rosco-m68k/rosco_m68k_pro/code/firmware/rosco_m68k_pro_development/README.md

# rosco_m68k Pro Firmware (development)

Developmental firmware for rosco_m68k pro. Currently WIP.
