rosco-m68k/rosco_m68k_pro/(threads)

Thread 9 (2021-12-07):

LED Blink on Pro is unreliable

roscopeco, 2021-12-07:
Duplicates https://github.com/rosco-m68k/rosco_m68k/issues/282 (issue is in code brought over from classic r2).

Will push a PR to fix shortly.

Closed 2021-12-08.
