rosco-m68k/rosco_m68k_pro/(list of files, drawings)

Other design files:
code/pld/mem_selects/selects.circ
