rosco-m68k/rosco_m68k_pro/(commit log)

2021-05-15 Initial work on design
    [CPU.sch, DUART.sch, GLUE.sch, RAM.sch, ROM.sch, rosco_pro_mini_040.kicad_pcb, rosco_pro_mini_040.sch]
2021-05-21 Initial import 030 design dev
    [CPU.sch, DUART.sch, GLUE.sch, RAM.sch, ROM.sch, rosco_pro_mini_030.kicad_pcb, rosco_pro_mini_030.sch]
2021-07-16 Update footprints for pro 030 mini
    [CPU.sch]
2021-07-16 Remove abortive minis, moving to full prototype
    [CPU.sch, DUART.sch, GLUE.sch, RAM.sch, ROM.sch, rosco_pro_mini_030.kicad_pcb, rosco_pro_mini_030.sch, rosco_pro_mini_040.kicad_pcb]
2021-07-16 First cut IC2 (L1 address decoder)
2021-07-16 First cut L2 decoder (O/B mem selects)
    [selects.circ]
2021-07-16 Initial work on 030 proto
    [CPU.sch, DUART.sch, GALs.sch, GLUE.sch, RAM.sch, ROM.sch, rosco_pro_030_proto.kicad_pcb, rosco_pro_030_proto.sch]
2021-07-23 First cut interrupt glue GAL
2021-07-23 Add interrupt glue to schematic
    [CPU.sch, DUART.sch, GALs.sch, GLUE.sch, RAM.sch, RESET.sch, ROM.sch, rosco_pro_030_proto.sch]
2021-07-24 Largeish changeset:
    * Added (first-cut) glue for DTACK generation
    * Fix mem selects to use new DTACK generation
    * Add missing footprints for Kicad
    * Add POWER and TESTPOINTS schematics
    * Update footprints across the board to allow error-free PCB import
    * Pull all components (so far) into PCB
    * Fix MC68030RC footprint (missing pads)
    [CPU.sch, DUART.sch, GALs.sch, GLUE.sch, POWER.sch, RAM.sch, RESET.sch, ROM.sch]
2021-07-25 Add DTACK delays and fixes
    * Add configurable DTACK delay for RAM & ROM
    * Add DTACK generation for RAM/ROM with delay support in IC5
    * Fix /BOOT line generator for 32-bit port
    [GALs.sch, GLUE.sch]
2021-07-25 Make DTACK delay input selectable, and update netlist
    [GLUE.sch, rosco_pro_030_proto.kicad_pcb]
2021-08-23 Interrupts + Xosera schematic, re-annotate
    [CPU.sch, DUART.sch, GALs.sch, GLUE.sch, INTERRUPTS.sch, LEVELSHIFT.sch, POWER.sch, RAM.sch]
2021-09-20 Big(ish) push on placement
    [CPU.sch, DUART.sch, GLUE.sch, INTERRUPTS.sch, POWER.sch, RESET.sch, rosco_pro_030_proto.kicad_pcb]
2021-09-23 Further layout
    [CPU.sch, GALs.sch, GLUE.sch, INTERRUPTS.sch, LEVELSHIFT.sch, POWER.sch, RESET.sch, XOSERA.sch]
2021-10-01 Add IO and XVID glue etc.
    * Add IO Select glue
    * Add Xosera glue
    * Add new glues to schematic
    * Clean up libs
    * Reannotate (again)
    [DUART.sch, GALs.sch, GLUE.sch, INTERRUPTS.sch, LEVELSHIFT.sch, POWER.sch, RESET.sch, XOSERA.sch]
2021-10-01 Use IACK signals from interrupt glue
2021-10-01 Finally fix ERC...
    [CPU.sch, GALs.sch, INTERRUPTS.sch, POWER.sch, RAM.sch, TESTPOINTS.sch, rosco_pro_030_proto.kicad_pcb]
2021-10-01 Lots of work
    * Sort out power and reset circuits, add ATX
    * Add PCF8584 and supporting GAL code
    * Stub out ATX board outline in PCB
    * Various other tidying up and prep for layout
    [CPU.sch, DUART.sch, GALs.sch, GLUE.sch, INTERFACE.sch, INTERRUPTS.sch, LEVELSHIFT.sch, POWER.sch]
2021-10-01 Reconnect PCF8584 clock to CLK_8M
    [INTERFACE.sch, rosco_pro_030_proto.kicad_pcb]
2021-10-01 3V3 decoupling / filtering
    [POWER.sch, rosco_pro_030_proto.kicad_pcb]
2021-10-01 First cut placement
    [GALs.sch, LEVELSHIFT.sch, POWER.sch, XOSERA.sch]
2021-10-07 Replace 7493s and 7404 with IC10 GAL
    [GALs.sch, GLUE.sch, POWER.sch, UNUSED.sch, XOSERA.sch]
2021-10-07 Replace all 7400 reset glue / boot logic with PLD
2021-10-07 Add IC14 GAL into schematic
    [GALs.sch, GLUE.sch, RESET.sch, UNUSED.sch]
2021-10-07 BOOT line requires 2 clocks, not 4, on 030
    [GALs.sch]
2021-10-31 Use correct ATX footprint and fix boot line routing
    [POWER.sch, rosco_pro_030_proto.csv]
2021-11-03 Fix some silly mistakes
    [CPU.sch, GLUE.sch, POWER.sch, RESET.sch]
2021-11-03 Unused wire removal
    [ROM.sch]
2021-11-20 Lots more changes
    * Add DIN expansion connectors (provisional pinout)
    * Fix incorrect address lines for RAM & ROM (Doh!)
    * Remove unused level shifters
    * Fix clock enables
    * Lots of other small fixes
    [CPU.sch, DUART.sch, GALs.sch, GLUE.sch, INTERFACE.sch, INTERRUPTS.sch, POWER.sch, RAM.sch]
2021-11-20 Add DIN41612 footprint
2021-11-30 Fix RW/RnW SNAFU
    [GALs.sch, INTERFACE.sch, XOSERA.sch]
2021-11-30 Fix DUART DTACK SNAFU
    [DUART.sch]
2021-11-30 Completely re-do selects with negative logic
    [selects.circ]
2021-11-30 Fix (another) hilarious mistake 😞
    * 8-bit ports wired to the wrong end of the bus
    * Another respin needed I think...
    [DUART.sch, INTERFACE.sch, XOSERA.sch]
2021-12-01 Individual device selects are active low too
2021-12-01 Fix new RRSEL in schematic
    [GALs.sch]
2021-12-02 Global replace 'firmware v2' with 'Pro Firmware'
    [ansicon.asm, ata.asm, ata.c, ata.h, ata_identify.h, bbsd.c, bbsd.h, bbspi.c]
2021-12-02 Add legacy SD / SPI header
    [DUART.sch, INTERFACE.sch]
2021-12-02 Fix incorrect D25 hookup
    [XOSERA.sch]
2021-12-02 Add power track width
2021-12-02 Fix interrupts and CPU speed for 030
    [cpuspeed.c, main1.c]
2021-12-02 Fix comment (e68k only has three bytes)
    [syscalls_asm.asm]
2021-12-04 Add ATA/IDE from Mark Murray
    [CPU.sch, DUART.sch, GALs.sch, GLUE.sch, INTERFACE.sch, INTERRUPTS.sch, POWER.sch, RAM.sch]
2021-12-08 Layout for ATA, plus fixes
    [ata-ide.sch]
2021-12-08 Tidy up a bit
    [ata-ide.sch]
2021-12-08 More tidy up
    [XOSERA.sch]
2021-12-09 Add panel header block
    [RESET.sch, ata-ide.sch]
2021-12-22 Fix incorrect address line hookup for Xosera
    [XOSERA.sch]
2021-12-29 Rerate DTn resistors
    [GALs.sch]
2021-12-30 More tidy up & swap layers
    [INTERFACE.sch, ata-ide.sch]
2021-12-30 Add new Xosera DTACK stretch GAL
    [GALs.sch, GLUE.sch, XOSERA.sch, ata-ide.sch]
2022-01-14 Migrate to KiCad 6
    [ATA-IDE.kicad_sch, CPU.kicad_sch, CPU.sch, DUART.kicad_sch, DUART.sch, GALs.kicad_sch, GALs.sch, GLUE.kicad_sch]
2022-01-26 Surface DS in various GALS
    [GALs.kicad_sch]
2022-01-26 Fix wrong A lines, add INTRQ pulldown
    [ATA-IDE.kicad_sch, rosco_pro_030_proto.kicad_sch]
2022-02-15 Fix misplaced GND|5V silk
