rosco-m68k/rosco_m68k_pro/(notices)

Notices in the files:
design/pro_030_proto/kicad/XOSERA.kicad_sch:
Copyright ©2021-2022 The Really Old-School Company Limited
Open Source Hardware (CERN OHL)
design/pro_040_mini/kicad/RAM.sch:
Copyright ©2021 The Really Old-School Company Limited
design/pro_030_proto/kicad/ATA-IDE.kicad_sch:
Open Source Hardware licenced under CERN Open Hardware Licence
Copyright ©2021 Mark Murray
